iotsoa/BatAn/photos/hardware/ACS712.jpg

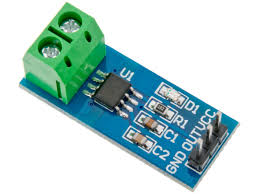
photos/hardware/ACS712.jpg
