iotsoa/BatAn/photos/hardware/ADS1115.jpg

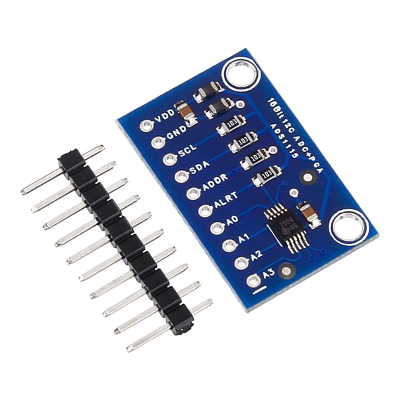
photos/hardware/ADS1115.jpg
