iotsoa/BatAn/photos/hardware/dduino.jpg

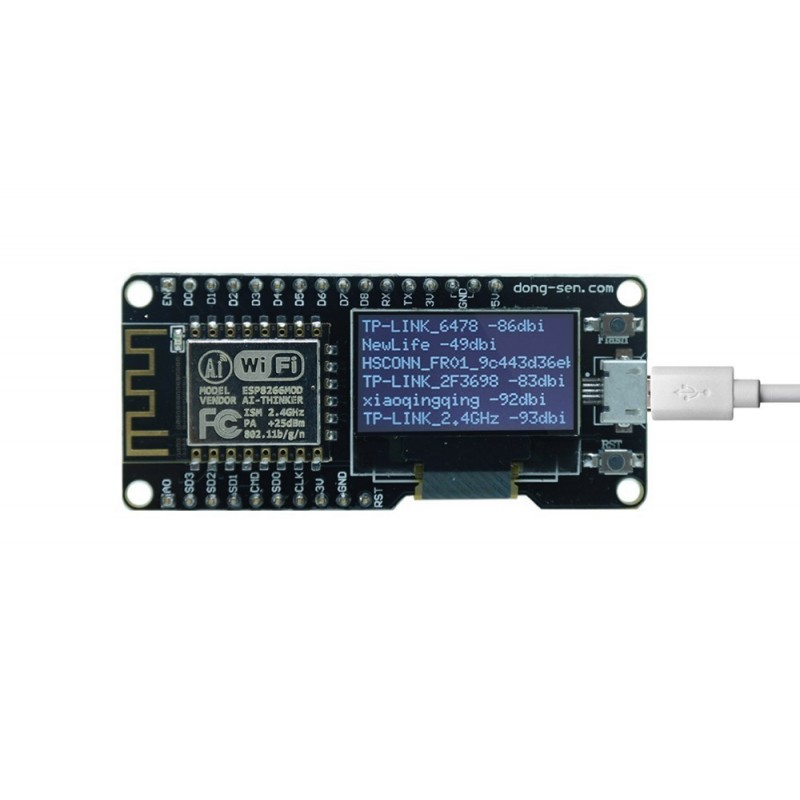
photos/hardware/dduino.jpg
