iotsoa/BatAn/photos/hardware/SSRelay.jpg

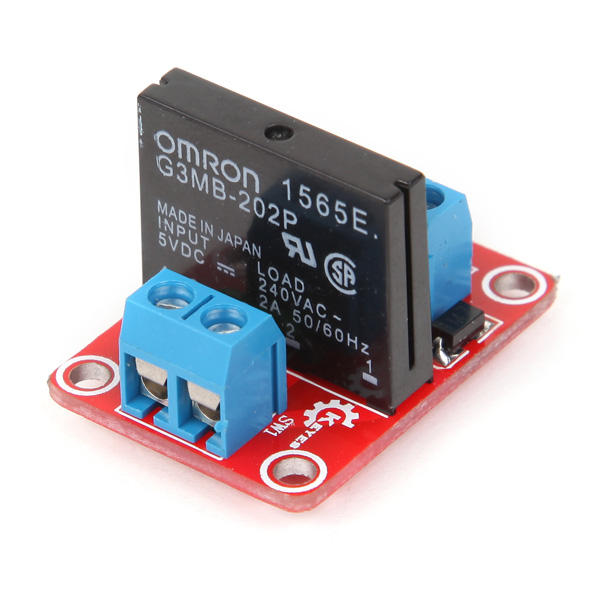
photos/hardware/SSRelay.jpg
