iotsoa/BatAn/photos/hardware/TTL_RS485.jpg

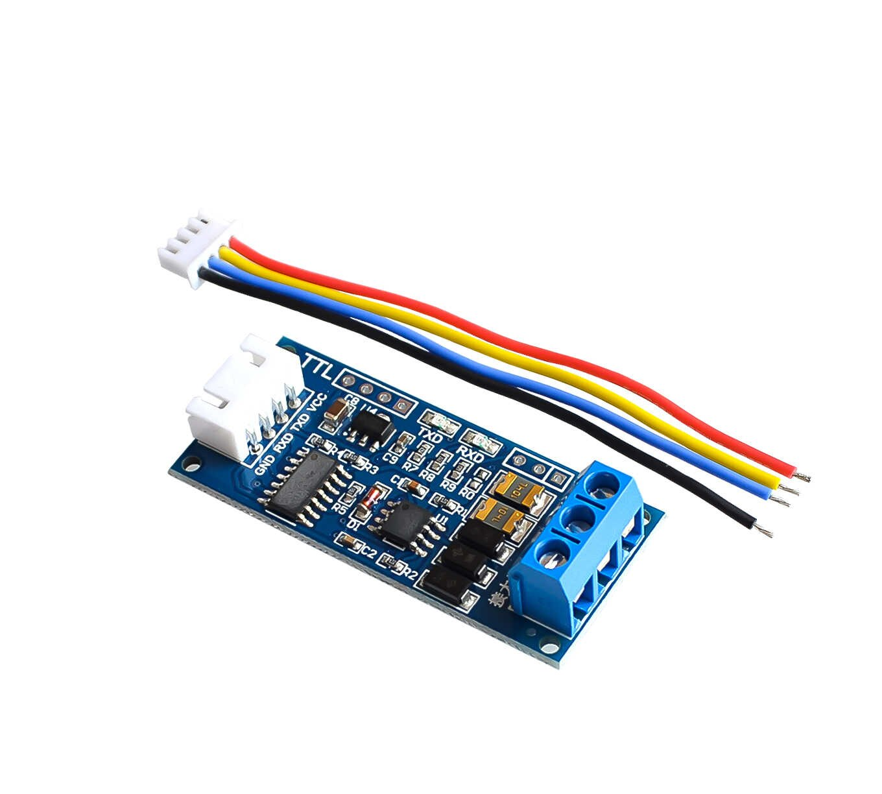
photos/hardware/TTL_RS485.jpg
