iotsoa/BatAn/photos/hardware/voltage_sensor.jpg

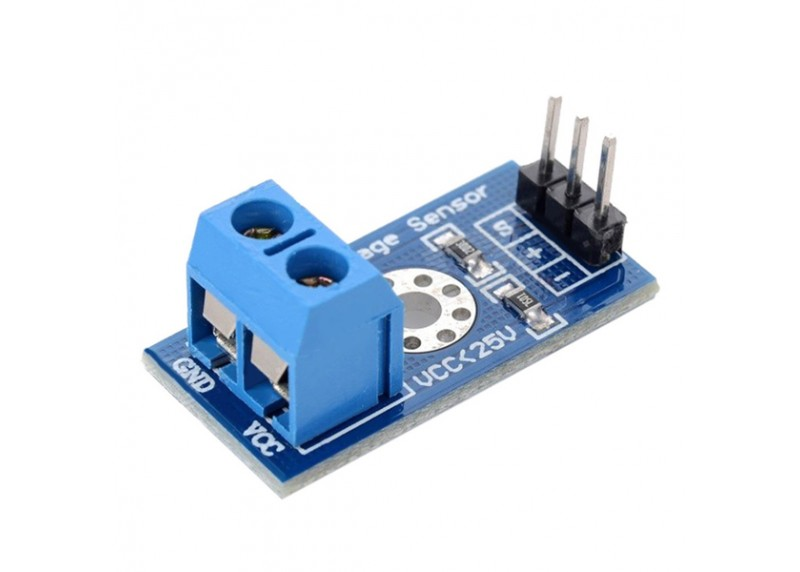
photos/hardware/voltage_sensor.jpg
