iotsoa/BatAn/photos/sensors.jpg

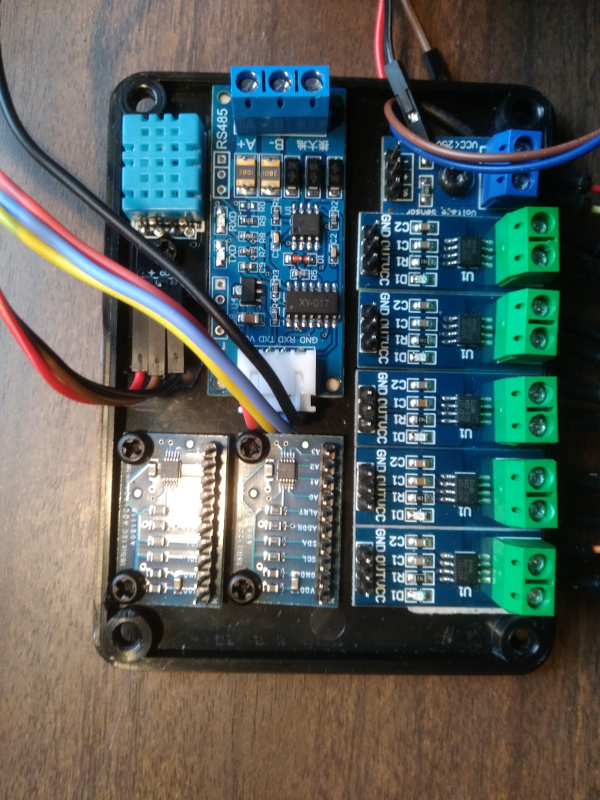
photos/sensors.jpg
