iotsoa/BatAn/photos/installation.jpg

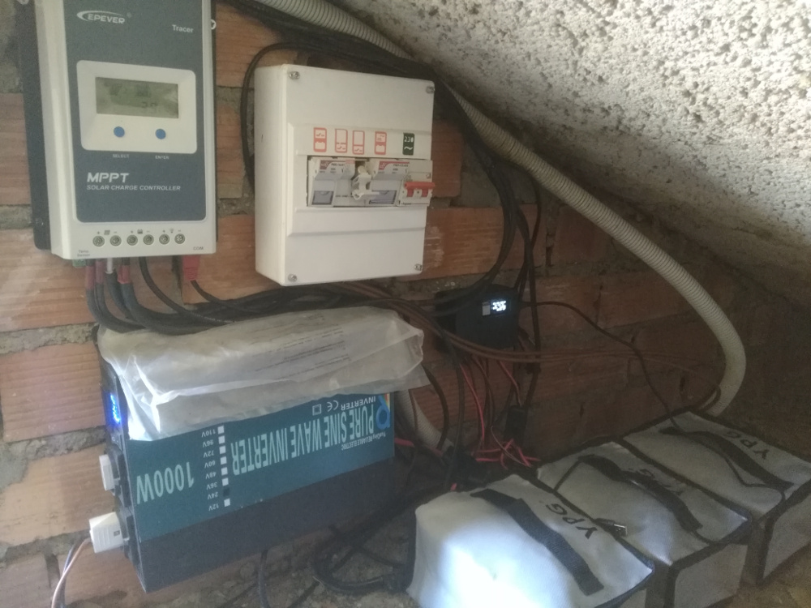
photos/installation.jpg
