iotsoa/BatAn/photos/testing.jpg

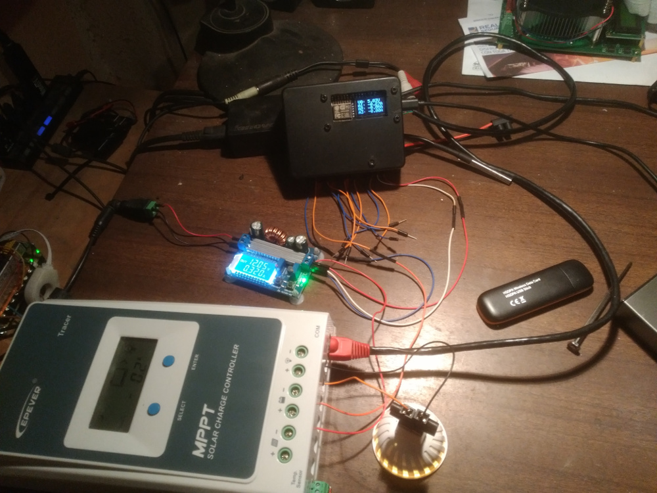
photos/testing.jpg
