iotsoa/BatAn/schematic/schem.pdf

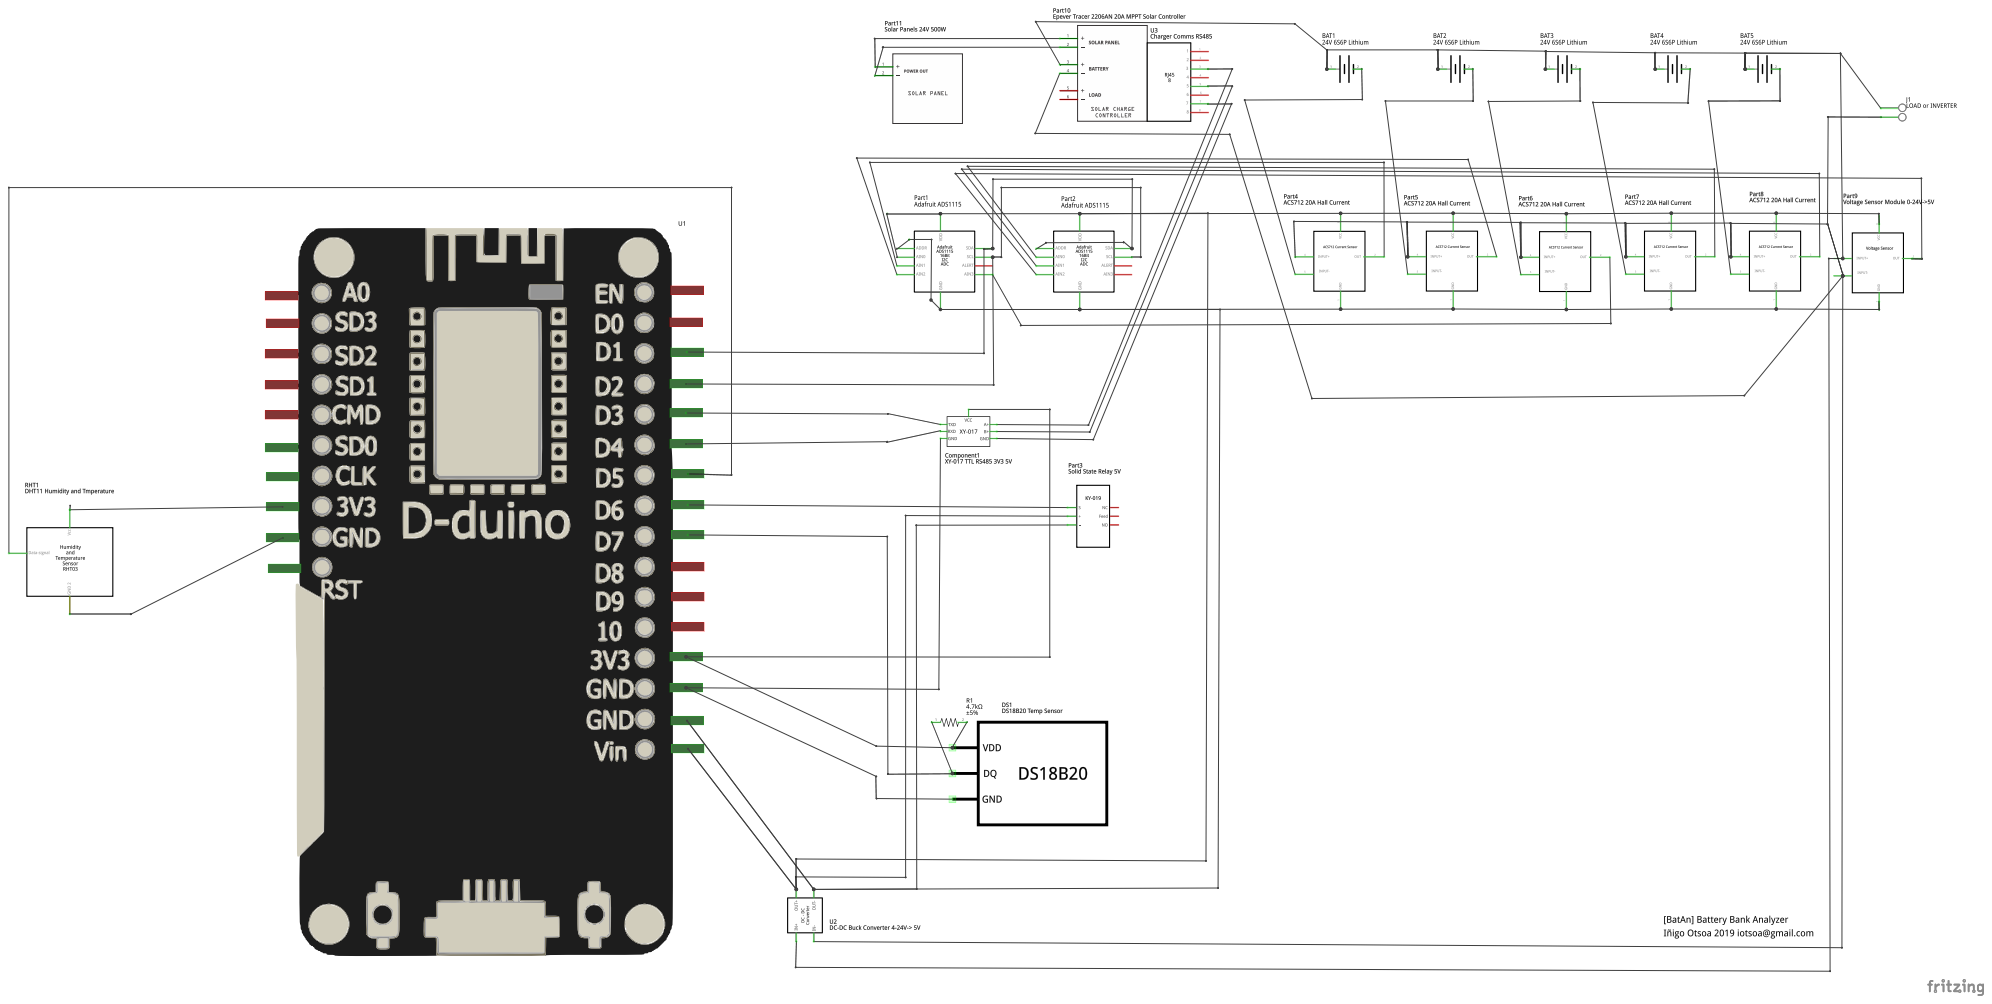
[picture p19: page 1]
